LeHack/SPSP/hardware/README.md

# SPSP - Hardware

One of the goals of the project was to make it modular and easily fittable into a housing (in order to protect the electronics from weather elements).  
Therefore I designed two easily detachable (via flat cable) PCBs:
* sensors PCB - for all the sensors to be joined together (excluding the PM10 sensor, which is attached via a separate cable, due to the nature of PM10 measurements)
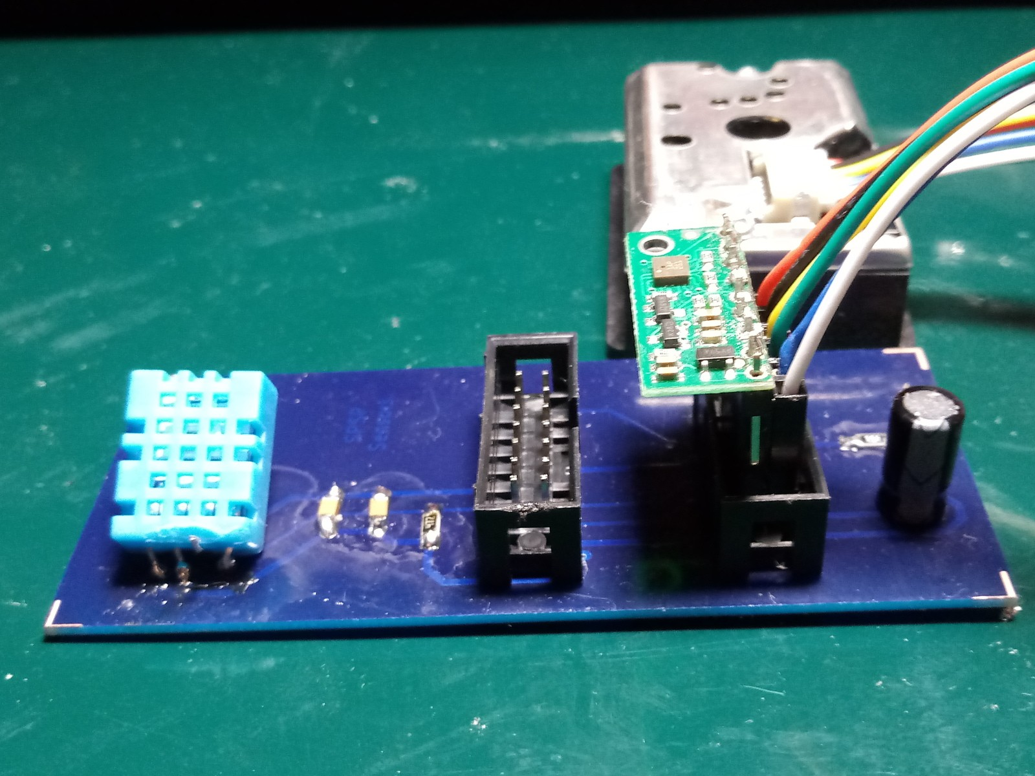
[picture p3: img/real_sensors.png]
  

* display and comms PCB - for the display (of own design), input switches and a communications module
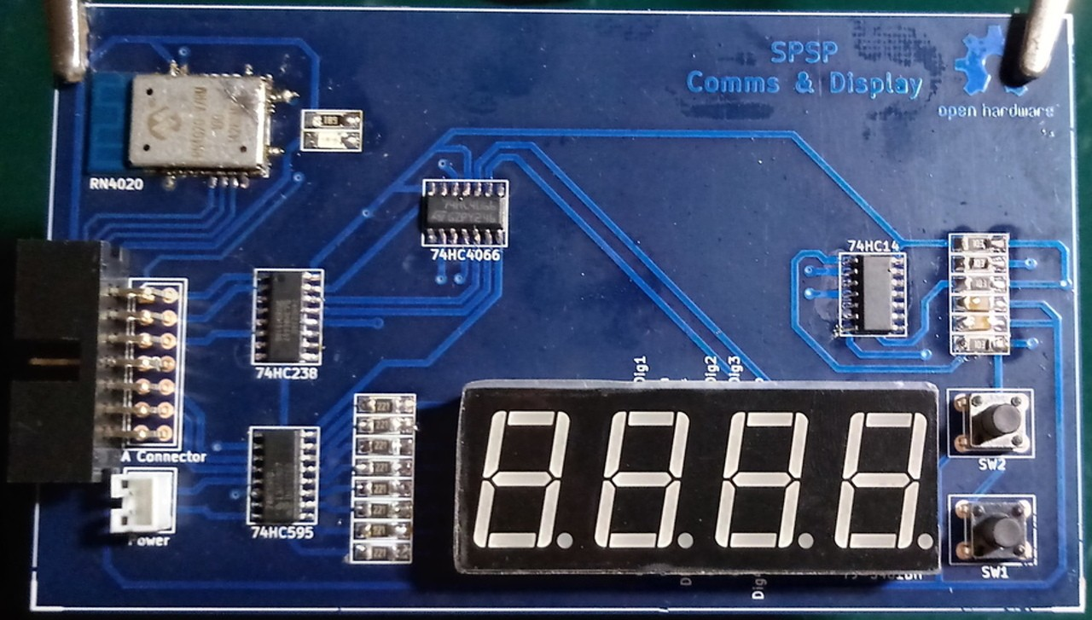
[picture p4: img/real_display.png]
  

### Sensors

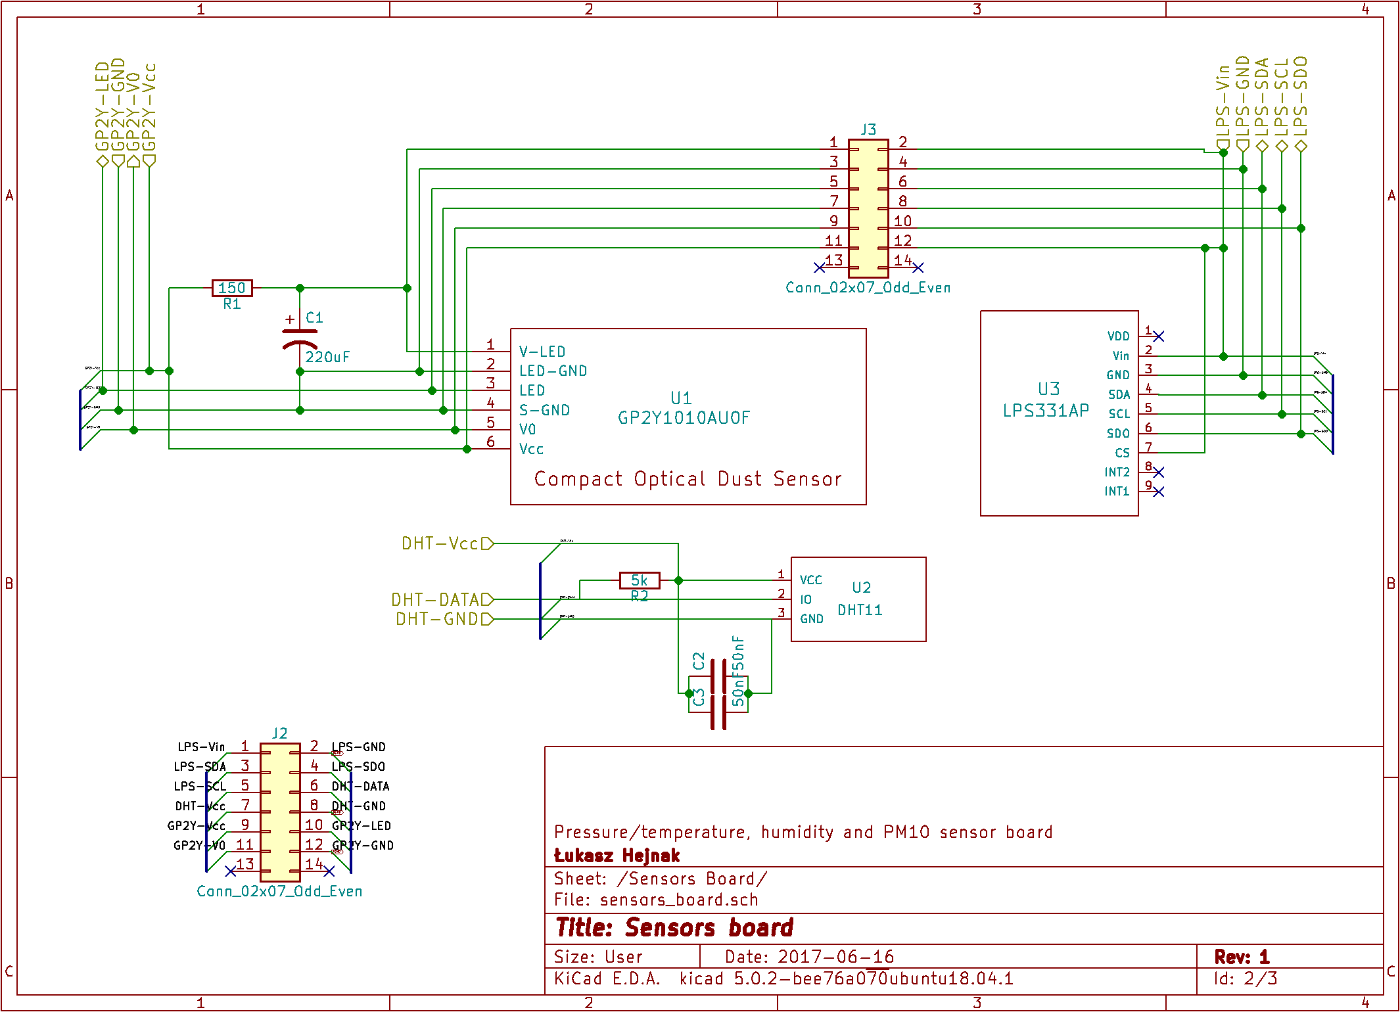
[picture p5: img/sch_sensors.png]
  
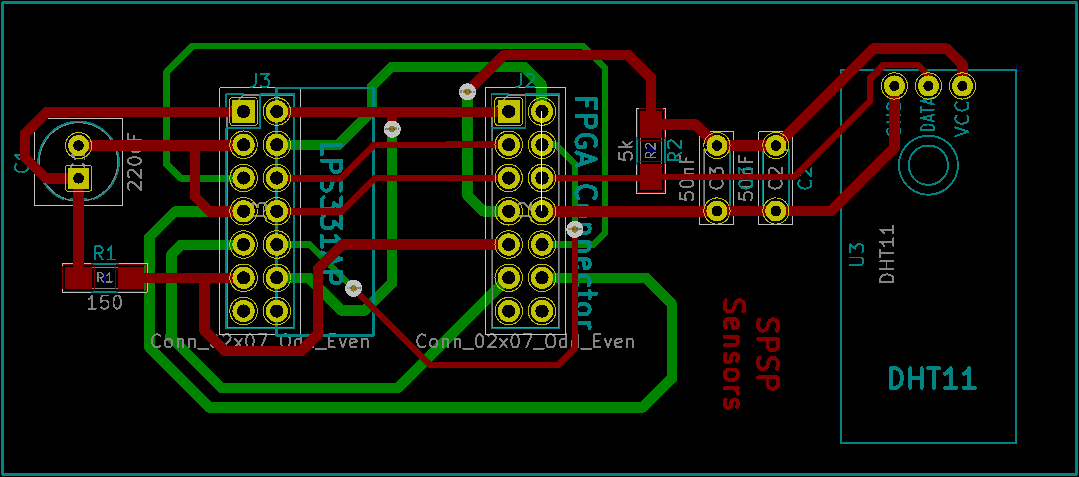
[picture p6: img/pcb_sensors.png]
  

### Display and comms

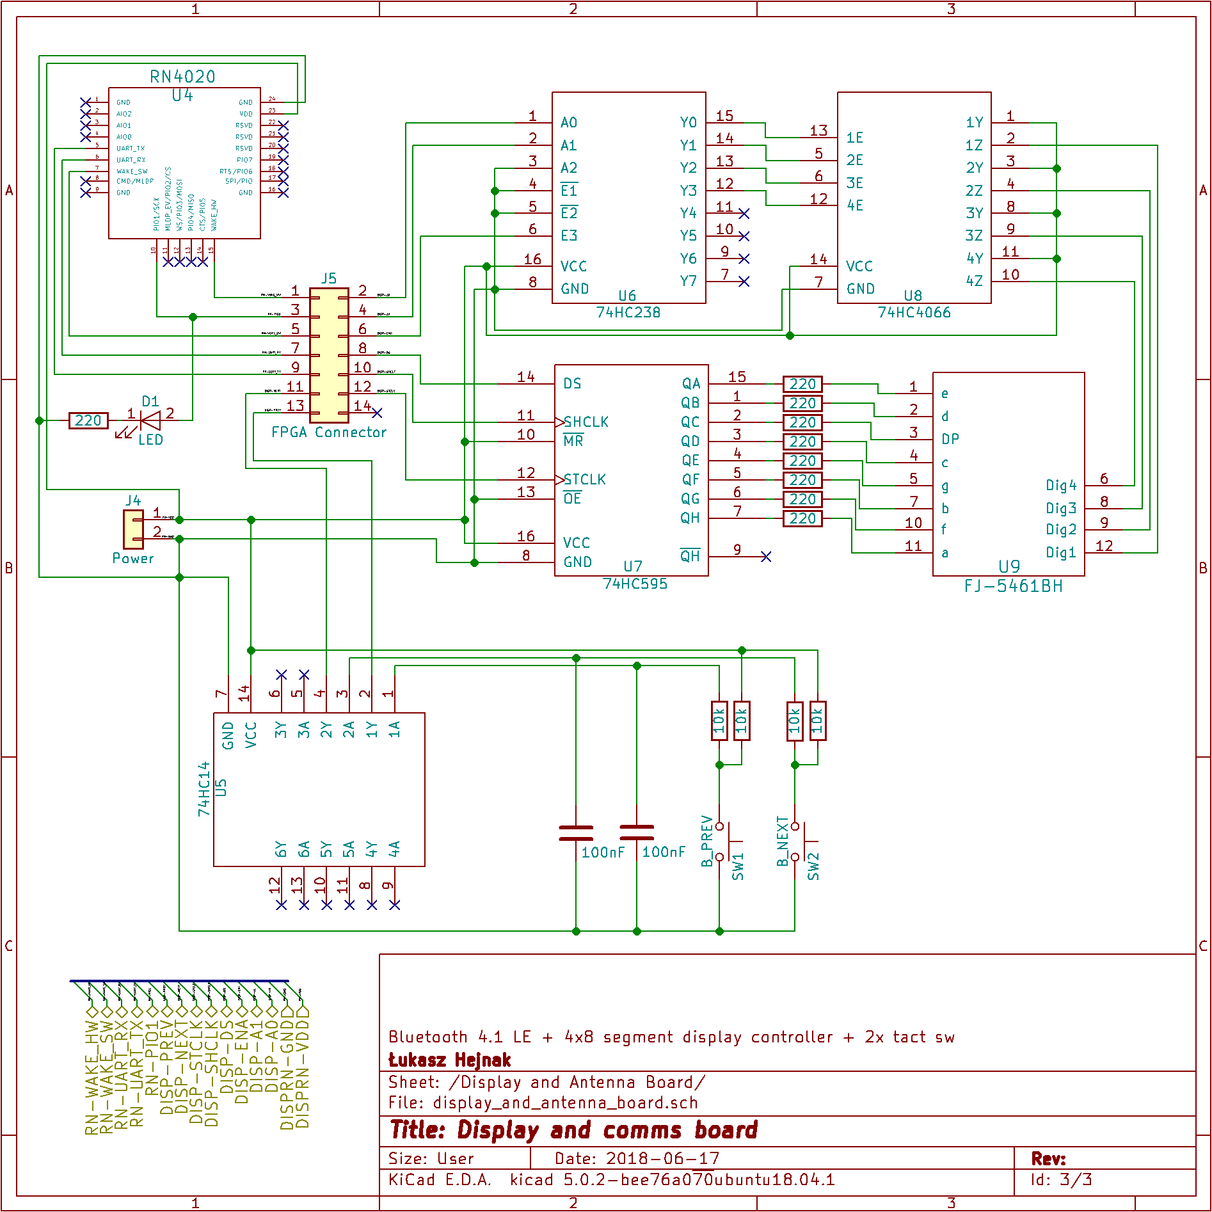
[picture p7: img/sch_display.png]
  
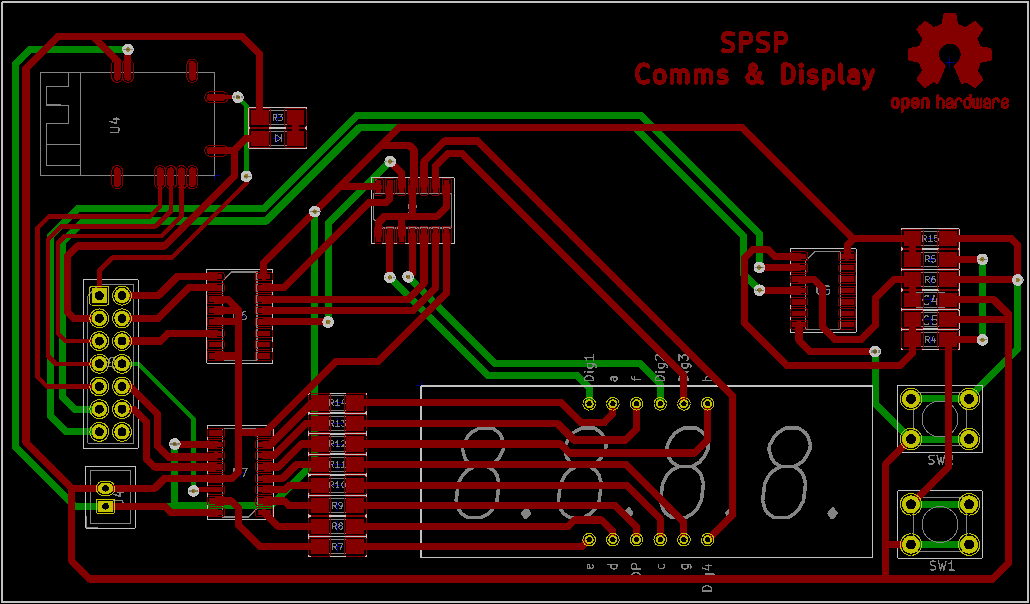
[picture p8: img/pcb_display.png]
