LeHack/SPSP/src/python/API/Readme.md

## SPSP - API binding for Python
This API django app is a standalone utility which can be used to access and control the device.
Here's a helpful diagram of what's available in the API:  
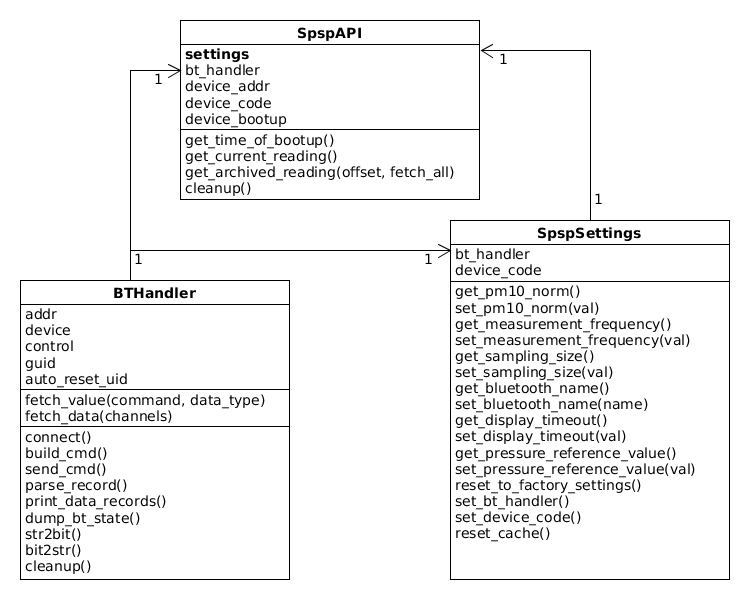
[picture p10: src/python/doc/SPSP_API_PY.png]
api


### API Command internals
In order to send an API command, one must:
* connect to the device
* pick the BT *command* channel (uuid: 0cc3e289-7a82-448e-bd8b-9d3552f5380a)
* put the command in the channel with an ID number (see below)
* wait till the ID field is incremented by 1 (meaning that the device responded)
* parse the channel contents to get the response

Command structure (20 bytes):  
command structure

:information_source: Every command is exactly 10 bytes. If a command is shorter, the row must be padded with zeroes.

Command flow example:  
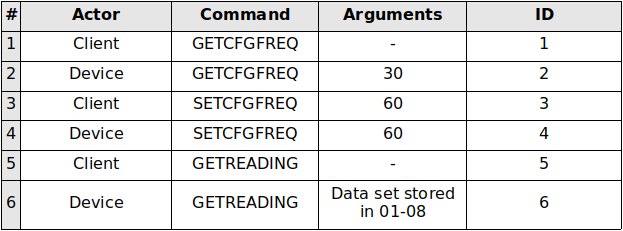
[picture p11: src/python/doc/SPSP_API_command_example.png]
command flow


### Available commands (:construction: under construction)
The following commands are available:

Command (10 bytes) | Arguments (8 bytes) | Description
--- | --- | ---
GETCFGPM10 | int [8 bits] | ...
GETCFGFREQ | int [8 bits] | ...
GETCFGSAMP | int [6 bits] | ...
GETBTNAME | SPSP (see below) | ...
GETPRESSPT | int [8 bits] | ...
GETDISPOFF | int [6 bits] | ...
SETCFGPM10 | int [8 bits] | ...
SETCFGFREQ | int [8 bits] | ...
SETCFGSAMP | int [6 bits] | ...
SETBTNAME | SPSP (see below) | ...
SETPRESSPT | int [8 bits] | ...
SETDISPOFF | int [6 bits] | ...
GETTMSTAMP | - | ...
GETREADING | - | ...
GETSTORED | int [20 bits] | ...
RESETUID | - | ...
RESETCFG | - | ...

### Fetching data (:construction: under construction)

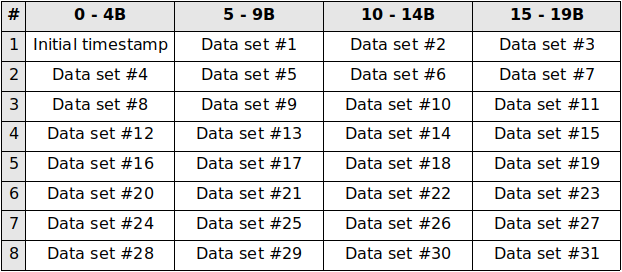
[picture p12: src/python/doc/SPSP_API_channel_data.png]
channel data contents


data set definition

:information_source: Due to the bit limit, I decided to use a value shift for negative temperature values (instead of using U2 code). Therefore the values in that field span from 0 (-40ºC) to 125 (+85ºC) and need to be down shifted after reading.

#### SPSP encoding
Due to limited resources for some commands (marked above) we decided to use our own 6bit encoding instead of the traditional 8bit variant. Therefore in order to send and receive commands from the device, one must apply additional I/O translation according this table:  
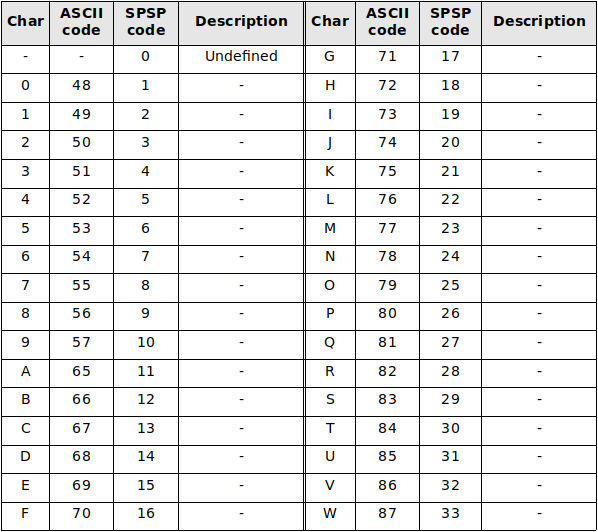
[picture p13: src/python/doc/SPSP_API_ascii1.png]
ascii2spsp1

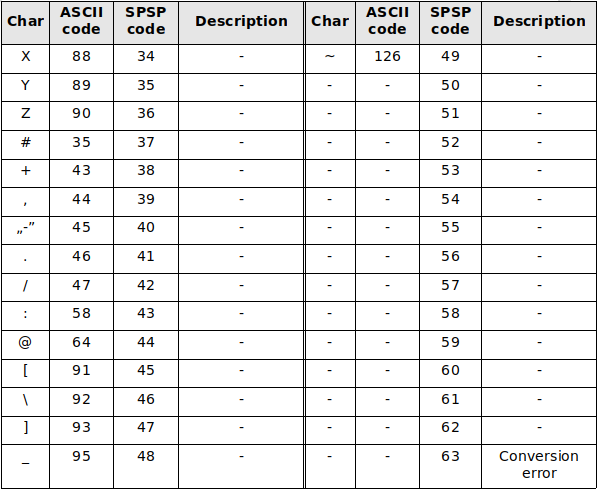
[picture p14: src/python/doc/SPSP_API_ascii2.png]
ascii2spsp2


Also see the available implementations:
* converting ASCII to SPSP argument encoding: API.BTHandler.str2bit()
* converting SPSP argument encoding to ASCII: API.BTHandler.bit2str()
