LeHack/SPSP/src/vhdl/SPSP-v1-0_description.txt

Added and tested the missing settings:
- pressure relative point
- display timeout
