LeHack/SPSP/src/vhdl/SPSP-v1-1_description.txt

Improved SDRAM storage, fixed bug in DHT11 driver and other smaller issues.
