LeHack/SPSP/src/vhdl/SPSP-v1-6_description.txt

Modified display and comms to fit the revised PCB
