LeHack/SPSP/src/vhdl/SPSPv0-8_description.txt

All modules integrated and working.
There are still issues with archived data (transfer or storage access related).
Also the pressure relative point is still hardcoded into the LPS driver.
Finally the set display timeout API command is missing.
