LeHack/SPSP/src/vhdl-dev/Communications/v1-1_description.txt

Switching Comms module API to enable/ready and intermediate flags for coop.
