LeHack/SPSP/hardware/sensors.kicad_pcb

## KiCad design hardware/sensors.kicad_pcb (2019-03-04)

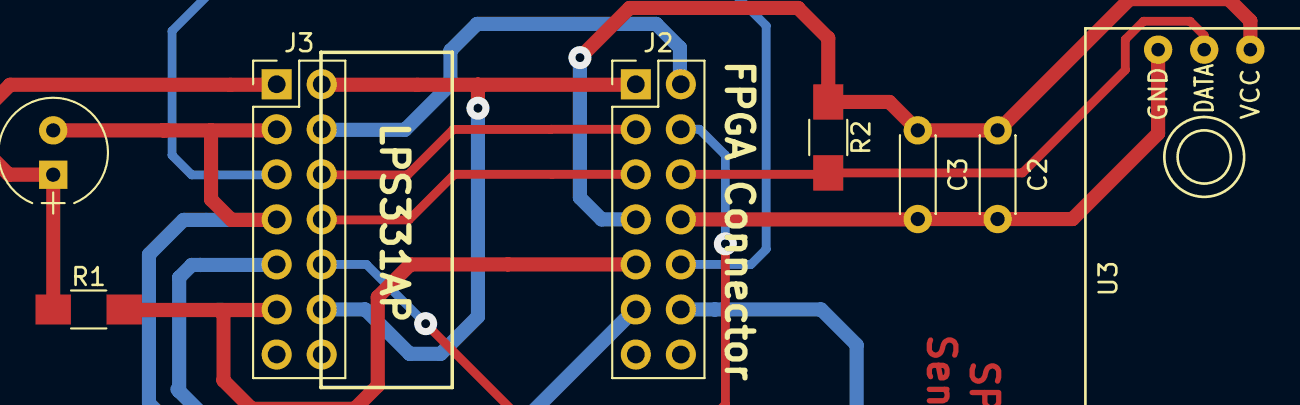
[picture p19: board sensors.kicad_pcb from above]

Board: 2 copper layers, 8 parts (0 on the bottom side), 12 nets.

Parts:
C1: 220uF; CP_Radial_Tantal_D6.0mm_P2.50mm
C2, C3: 50nF; C_Disc_D4.3mm_W1.9mm_P5.00mm
J2, J3: Conn_02x07_Odd_Even; Pin_Header_Straight_2x07_Pitch2.54mm
R1: 150; R_1206_HandSoldering
R2: 5k; R_1206_HandSoldering
U3: DHT11

Connections:
/DHT-DATA: J2.6, R2.2, U3.2
/DHT-Vcc: C2.1, C3.1, J2.7, R2.1, U3.1
/GP2Y-LED: J2.10, J3.5
/GP2Y-V0: J2.11, J3.9
/GP2Y-Vcc: J2.9, J3.11, R1.2
/LPS-SCL: J2.5, J3.8
/LPS-SDA: J2.3, J3.6
/LPS-SDO: J2.4, J3.10
/LPS-Vin: J2.1, J3.2, J3.12
AGND: C1.2, J2.12, J3.3, J3.7
DGND: C2.2, C3.2, J2.2, J2.8, J3.4, U3.3
unnamed: C1.1, J3.1, R1.1
