LeHack/SPSP/hardware/display_and_comms.kicad_pcb

## KiCad design hardware/display_and_comms.kicad_pcb (2019-03-04)

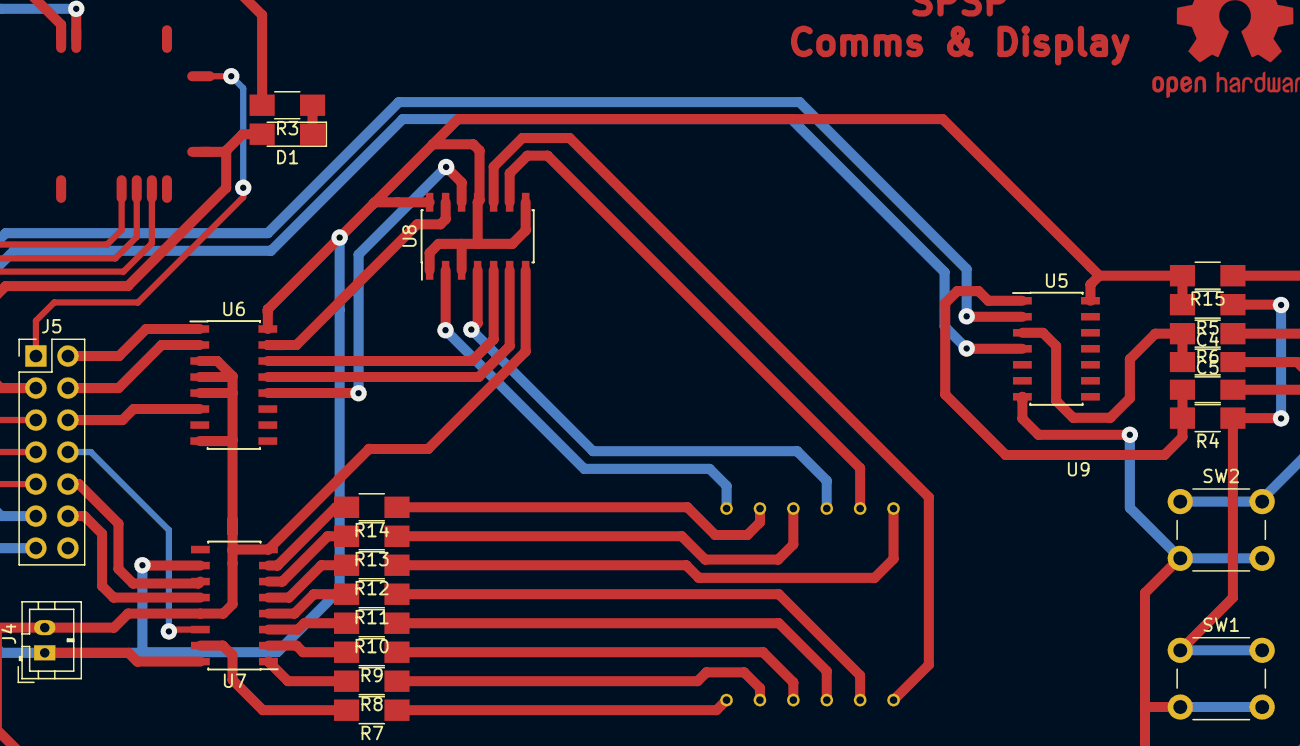
[picture p20: board display_and_comms.kicad_pcb from above]

Board: 2 copper layers, 26 parts (0 on the bottom side), 44 nets.

Parts:
C4, C5: 100nF; C_1206_HandSoldering
D1: LED; LED_1206_HandSoldering
J4: Power; JST_PH_B2B-PH-K_02x2.00mm_Straight
J5: FPGA Connector; Pin_Header_Straight_2x07_Pitch2.54mm
R3, R7, R8, R9, R10, R11, R12, R13, R14: 220; R_1206_HandSoldering
R4, R5, R6, R15: 10k; R_1206_HandSoldering
SW1: B_PREV; SW_PUSH_6mm_h8mm
SW2: B_NEXT; SW_PUSH_6mm_h8mm
U4: RN4020
U5: 74HC14; SOIC-14_3.9x8.7mm_Pitch1.27mm
U6: 74HC238; SOIC-16_3.9x9.9mm_Pitch1.27mm
U7: 74HC595; SOIC-16_3.9x9.9mm_Pitch1.27mm
U8: 74HC4066; SOIC-14_3.9x8.7mm_Pitch1.27mm
U9: FJ-5461BH

Connections:
/DISP-A0: J5.2, U6.1
/DISP-A1: J5.4, U6.2
/DISP-DS: J5.8, U7.14
/DISP-ENA: J5.6, U6.6
/DISP-NEXT: J5.11, U5.4
/DISP-PREV: J5.13, U5.2
/DISP-SHCLK: J5.10, U7.11
/DISP-STCLK: J5.12, U7.12
/DISPRN-VDD: J4.1, R5.2, R15.2, U4.23, U5.14, U6.16, U7.10, U7.16, U8.1, U8.3, U8.8, U8.11, U8.14
/RN-PIO1: D1.2, J5.3, U4.10
/RN-UART_RX: J5.7, U4.6
/RN-UART_TX: J5.9, U4.5
/RN-WAKE_HW: J5.1, U4.15
/RN-WAKE_SW: J5.5, U4.7
DGND: C4.2, C5.2, J4.2, R3.2, SW1.2, SW2.2, U4.24, U5.7, U6.3, U6.4, U6.5, U6.8, U7.8, U7.13, U8.7
unnamed: C4.1, R6.2, U5.3
unnamed: C5.1, R4.2, U5.1
unnamed: D1.1, R3.1
unnamed: R4.1, R5.1, SW1.1
unnamed: R7.1, U9.1
unnamed: R7.2, U7.15
unnamed: R8.1, U9.2
unnamed: R8.2, U7.1
unnamed: R9.1, U9.3
unnamed: R9.2, U7.2
unnamed: R10.1, U9.4
unnamed: R10.2, U7.3
unnamed: R11.1, U9.5
unnamed: R11.2, U7.4
unnamed: R12.1, U9.7
unnamed: R12.2, U7.5
unnamed: R13.1, U9.10
unnamed: R13.2, U7.6
unnamed: R14.1, U9.11
unnamed: R14.2, U7.7
unnamed: R6.1, R15.1, SW2.1
unnamed: U6.12, U8.12
unnamed: U6.13, U8.6
unnamed: U6.14, U8.5
unnamed: U6.15, U8.13
unnamed: U8.2, U9.12
unnamed: U8.4, U9.9
unnamed: U8.9, U9.8
unnamed: U8.10, U9.6
