LeHack/SPSP/(commit log)

2019-03-04 Added hardware projects (KiCad) and a lot of docs.
    [display_and_antenna_board.sch, display_and_comms.csv, display_and_comms.kicad_pcb, sensors.csv, sensors.kicad_pcb, sensors_and_display_boards.sch, sensors_board.sch]
2019-03-04 Added real PCB photos. Also moved API binding diagram to API Readme.
2019-03-04 Added protocol/interface used by each driver.
